Volver-era/ERA-platform./README.md

# ©ERA-platform.2022
Платформа для разработке на ее основе собственных роботов 
- VK:https://vk.com/explorerrobotanimal
- Twitter:https://twitter.com/ERA17434195?s=09
- YouTube:https://youtube.com/channel/UC19MgV3cm7GwOPX2njeCrkA
