Volver-era/ERA-platform./малые версии платформы/ERA v3/README.md

# Что нового:
- 1)Немного переделана можель платформы
- 2)добавлена 2-ая точка крепления ног, из за чего практически изчез люфт конечностей 
- 3)Контроллер быд заменен на STM31f401
- 4)Сервоприводы изменены на MG90S
