Volver-era/ERA-platform./малые версии платформы/ERA v3/инструкция по сборке/README.md

# Что понадобится 
-   Основные компоненты:
-     *STM32F401 (STM32F103, STM32F411 или любая плата Adruino с достаточным количеством портов)
-     *Li-ion аккумуляторы 18650(x2)
-     *Сервоприводы (Mg90s) (х12)
-   Второстепенные компоненты: 
-     *Провода(тонкие – сигнальные, толстые – на питание)
-     *Переключатель питания
-     *Холдер для 18650 
-     *Термоусадочная трубка
-     *Гайки М3 (х4)
-     *Болты М3х10 (х4)
-     *Болты М3х5 (х12)
-     *Стержни (х24)
-     *Саморезы (для крепления сервоприводов) (х52)
-   Инструменты и оборудование:
-     *3D-принтер 
-     *Паяльник и припой 
-     *Супер клей
-     *Нож 
-     *USB-кабель прошивки arduino
-     *Пк/ноутбук для программирования робота, печати и т.д.
-   Программное обеспечение:
-     *Arduino IDE (для программирования)
-     *Fushion 360 (для редактирования 3D модели)
-     *Ultimaker Cura (для печати модели)

# Cборка

Alt-текст
Печатаем все детали из папки “3D Модель” в количестве указанном в названии 

Alt-текст
Очищаем от поддержек и лишнего пластика  

Alt-текст
Для сборки бедра понадобится:
*напечатанная бедренная часть
*сервопривод (х2)
*стержень(х4)
*саморезы для крепления серв(х8)
*болты (х2)

Alt-текст
Просовываем стержни в место крепления серв 

Alt-текст
вставляем болты в напечатанную модель

Alt-текст
Вставляем сервы со стержнями в напечатанную модель
(причем стараемся просунуть провод управления под вторым сервоприводом)

Alt-текст
Alt-текст
Закручиваем саморезы в стержни с обоих сторон 

Alt-текст
Собираем 4 бедра 
2 левых, и 2 правых

Alt-текст
Для сборки плечевого сустава понадобится:
*напечатанный плечевой сустав
*сервоприводы (х2)
*стержни (х4)
*болты (х2)
*гайки (х2)
*саморезы (х8)

Alt-текст
Также вставляем стержни в место крепления серво 

Alt-текст
так же вставляем болты.
И запрессовываем гайки в предназначенное место 

Alt-текст
вставляем сервы 

Alt-текст
Закручиваем саморезы с двух сторон 

Alt-текст
Для сборки корпуса необходимо смазать клеем все места отмеченные красным цветом 

Alt-текст
И соединить данным образом 
Но так чтобы все стенки были ровно под углом в 90*

Alt-текст
Далее собираем плечи
Для этого нужны плечевые суставы и крепления плечей 

Alt-текст
Alt-текст
Ставим плечевые крепления таким образом чтобы плечи были направлены вперед под углом в 45*

Alt-текст
Далее собираем тело 
Для этого берем склеенное ранее тело, собранные плечи и 4 длинных болта 

Alt-текст
Alt-текст
Alt-текст
Вставляем болты в предназначенные для них места в теле, и прикручиваем плечи  

Alt-текст
Alt-текст
Далее присоединяем бедра, так чтобы сервы были повернуты вниз  

Alt-текст
Alt-текст
И под конец, ставим голени 

Alt-текст
Alt-текст
финальный вид платформы
