Volver-era/ERA-platform./малые версии платформы/ERA v3/модель/README.md

# Настройки для 3D-печати 
-   Пластик:PLA
-   Толщина сопла 0.4
-   Температура сопла 210
-   Температура стола 65
-   Заполнение 15% (сотами)
-   Остальные настройки стандартные 

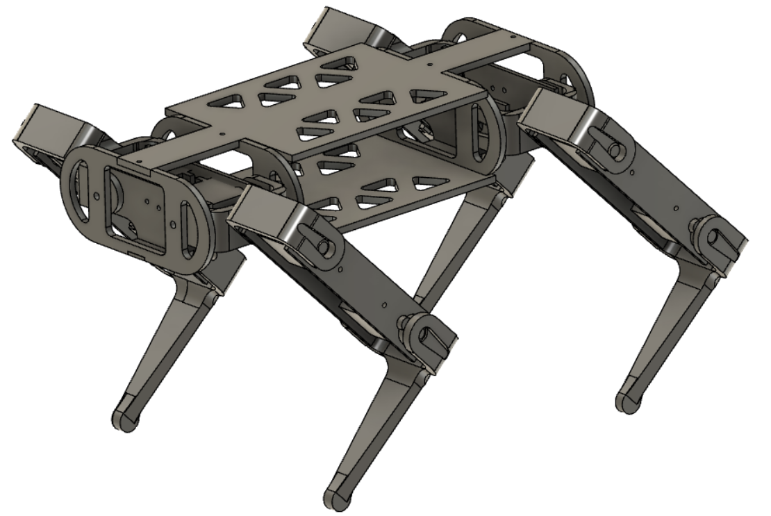
[picture p1: малые версии платформы/ERA v3/модель/Снимок экрана (4).png]
Alt-текст
