Volver-era/ERA-platform./малые версии платформы/ERA v2/README.md

# Что нового:
- 1)Полностью переделана модель платформы 
- 2)Корпусу добавлены стенки, что позволило сделать его крепче, и предотвратить компоненты от удара.
- 3)Контроллер был заменен на Arduino Mega
- 4)Сервоприводы изменены на SG92R
