Volver-era/ERA-platform./малые версии платформы/ERA v1/README.md

# Первая модель платформы
# На первой модели установлены 
- 1)Микроконтроллер Arduino mini
- 2)Cервоприводы Sg90 
# Модель 
- Создана простейшая платформа, для тестирования программы для ходьбы
