Volver-era/ERA-platform./большие версии платформы/ERA v1/фото/03AcDUjwing.jpg

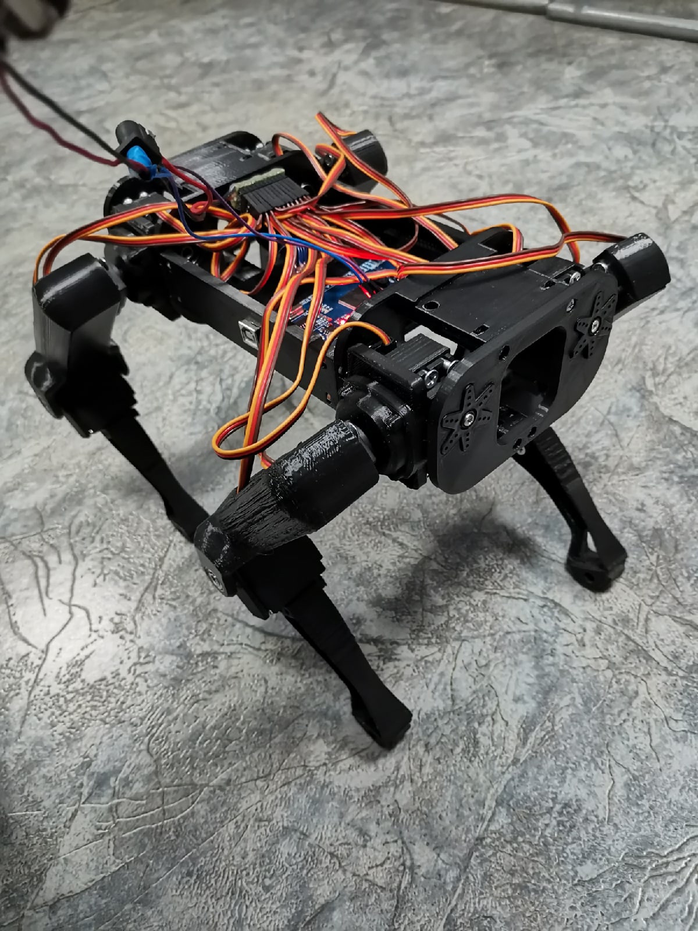
большие версии платформы/ERA v1/фото/03AcDUjwing.jpg
