Volver-era/ERA-platform./большие версии платформы/ERA v1/фото/5-9P0uYwGg0.jpg

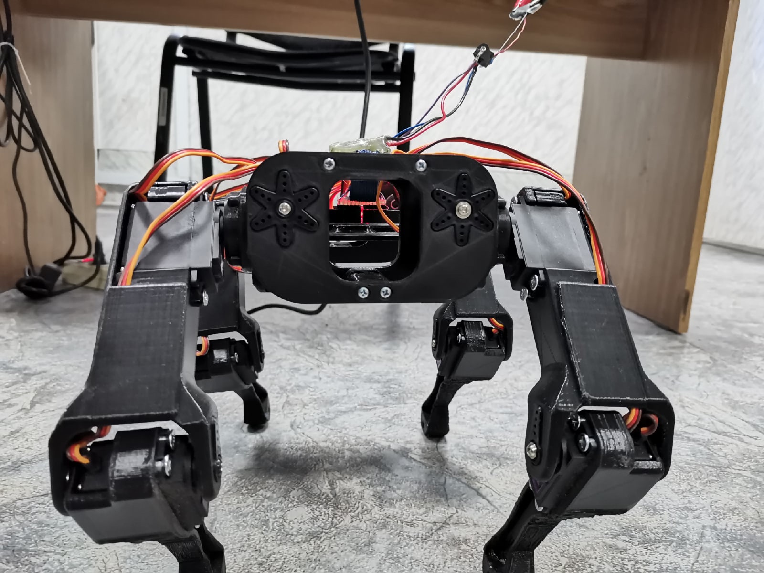
большие версии платформы/ERA v1/фото/5-9P0uYwGg0.jpg
