Volver-era/ERA-platform./большие версии платформы/ERA v1/фото/fQCVnL3XfMo.jpg

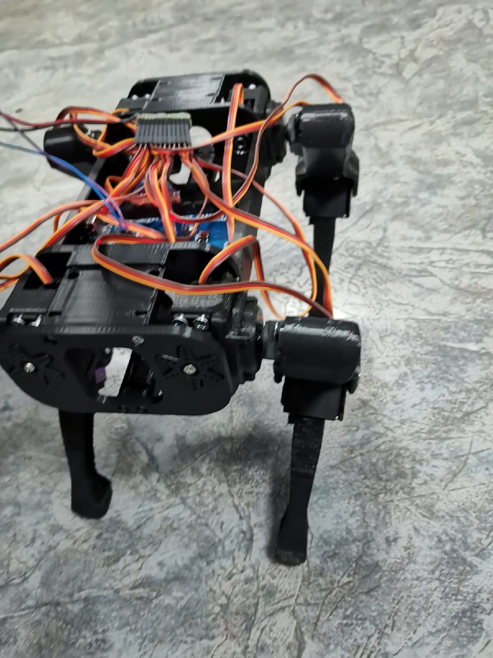
большие версии платформы/ERA v1/фото/fQCVnL3XfMo.jpg
