Volver-era/ERA-platform./большие версии платформы/ERA v1/фото/HJ_dtE6l62w.jpg

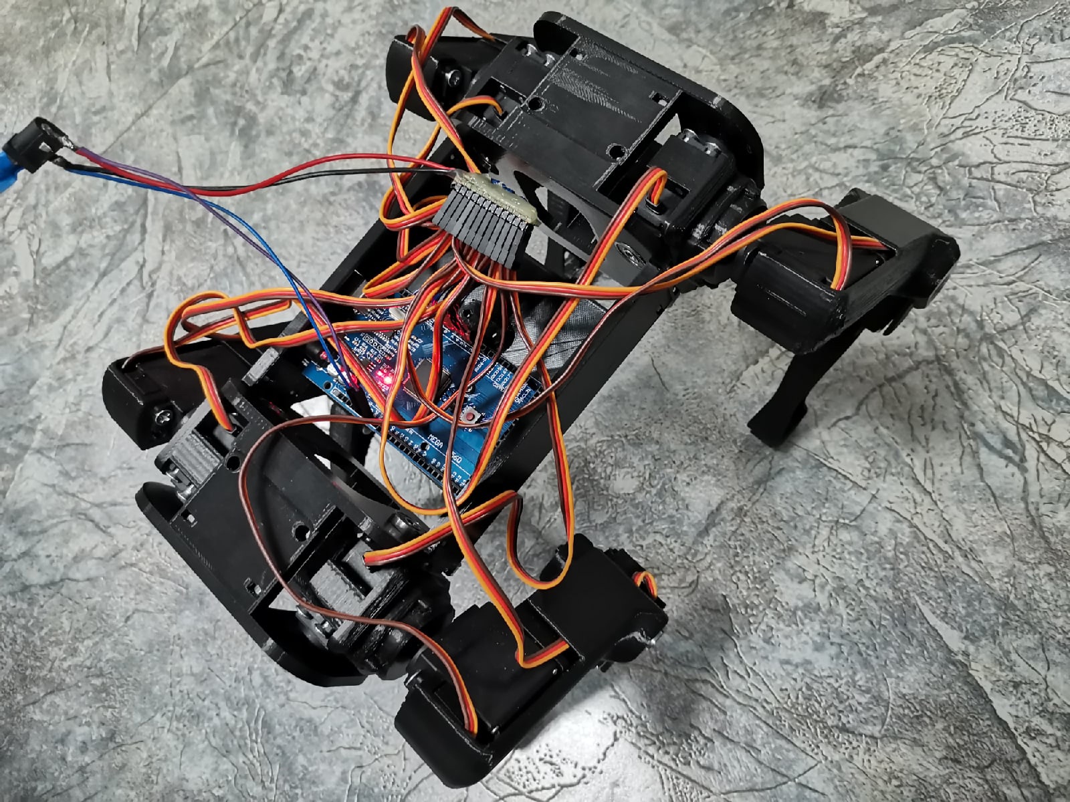
большие версии платформы/ERA v1/фото/HJ_dtE6l62w.jpg
