Volver-era/ERA-platform./большие версии платформы/ERA v1/фото/IlKXpyXIikI.jpg

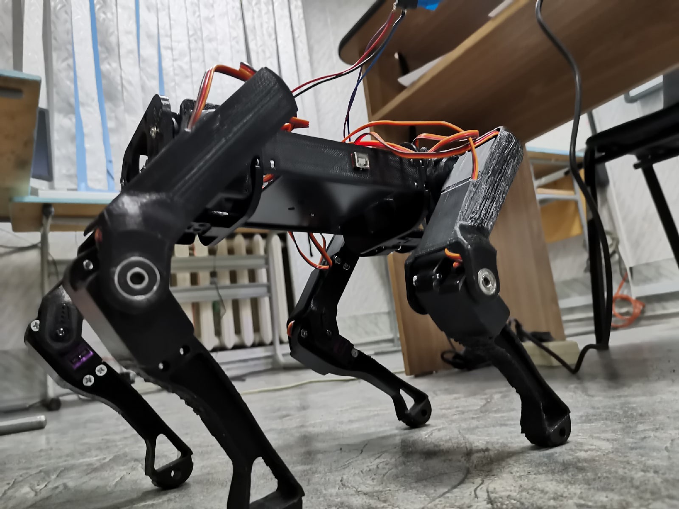
большие версии платформы/ERA v1/фото/IlKXpyXIikI.jpg
