Volver-era/ERA-platform./большие версии платформы/ERA v1/фото/IZdFxkf7L7s.jpg

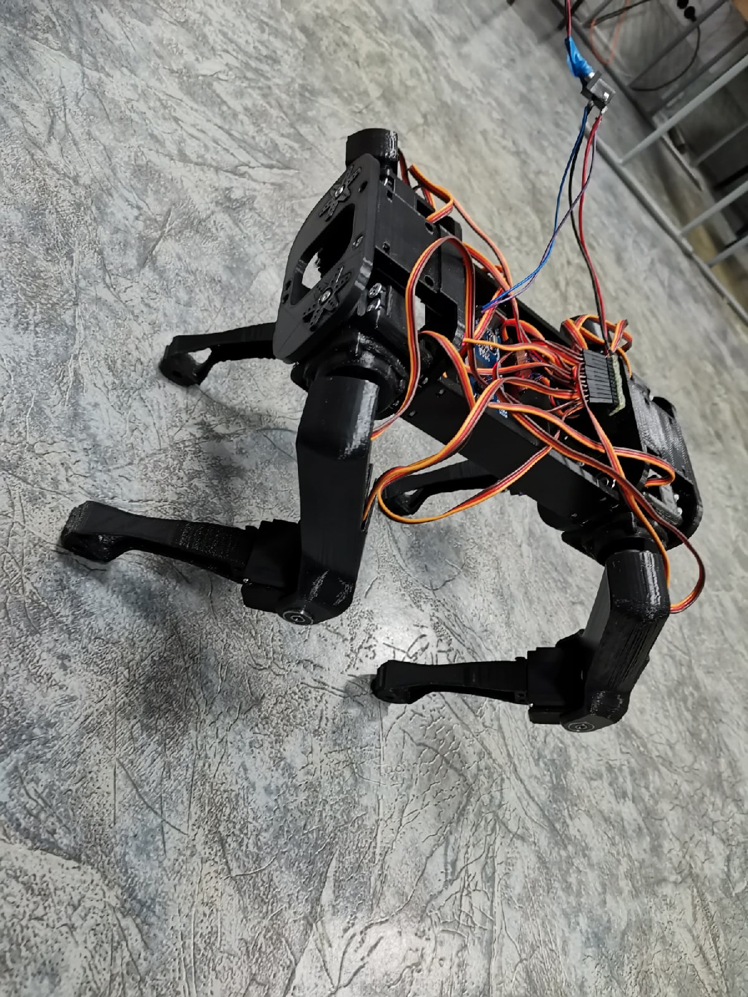
большие версии платформы/ERA v1/фото/IZdFxkf7L7s.jpg
