Volver-era/ERA-platform./большие версии платформы/ERA v1/фото/KXq7CZJiPGc.jpg

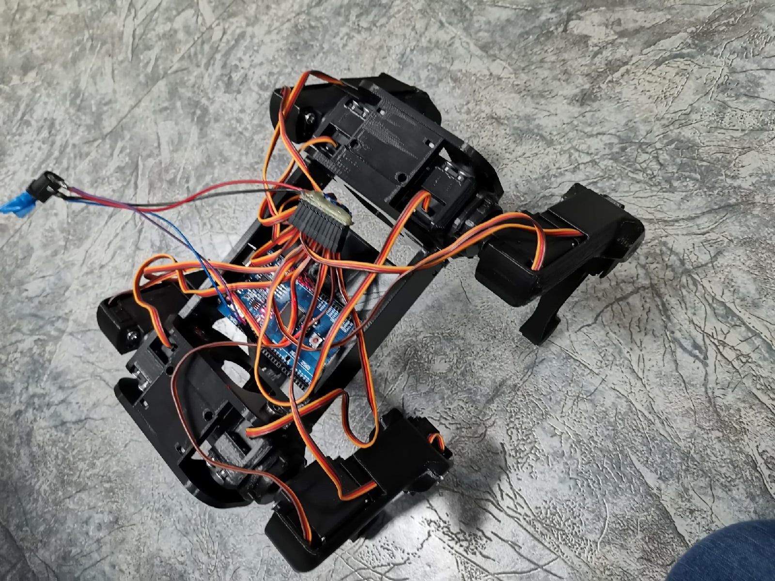
большие версии платформы/ERA v1/фото/KXq7CZJiPGc.jpg
