Volver-era/ERA-platform./большие версии платформы/ERA v1/фото/lwI6eKDuc0o.jpg

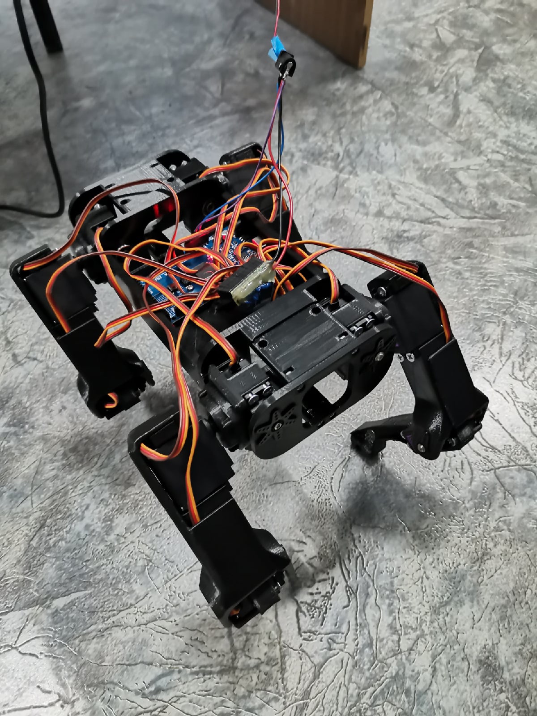
большие версии платформы/ERA v1/фото/lwI6eKDuc0o.jpg
