Volver-era/ERA-platform./большие версии платформы/ERA v1/фото/ov22cSXUDSg.jpg

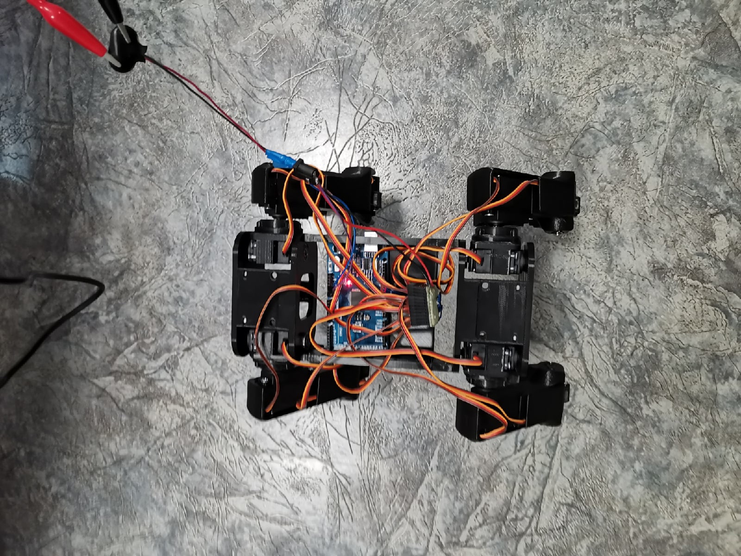
большие версии платформы/ERA v1/фото/ov22cSXUDSg.jpg
