Volver-era/ERA-platform./большие версии платформы/ERA v1/фото/R4x8xW7jYrg.jpg

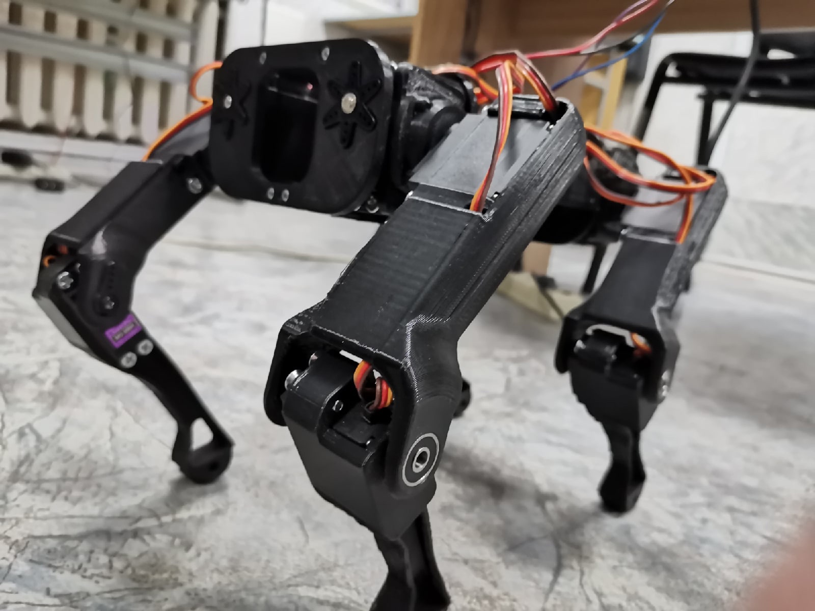
большие версии платформы/ERA v1/фото/R4x8xW7jYrg.jpg
