Volver-era/ERA-platform./большие версии платформы/ERA v1/фото/TSFQKXMkGRk.jpg

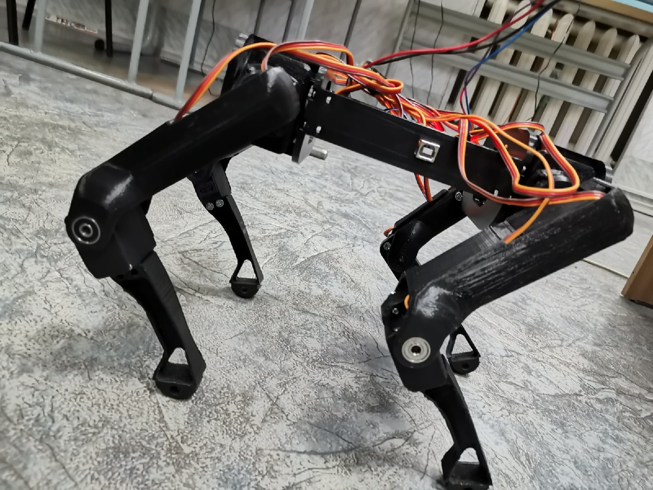
большие версии платформы/ERA v1/фото/TSFQKXMkGRk.jpg
