Volver-era/ERA-platform./большие версии платформы/ERA v1/фото/V23C5B-QcHU.jpg

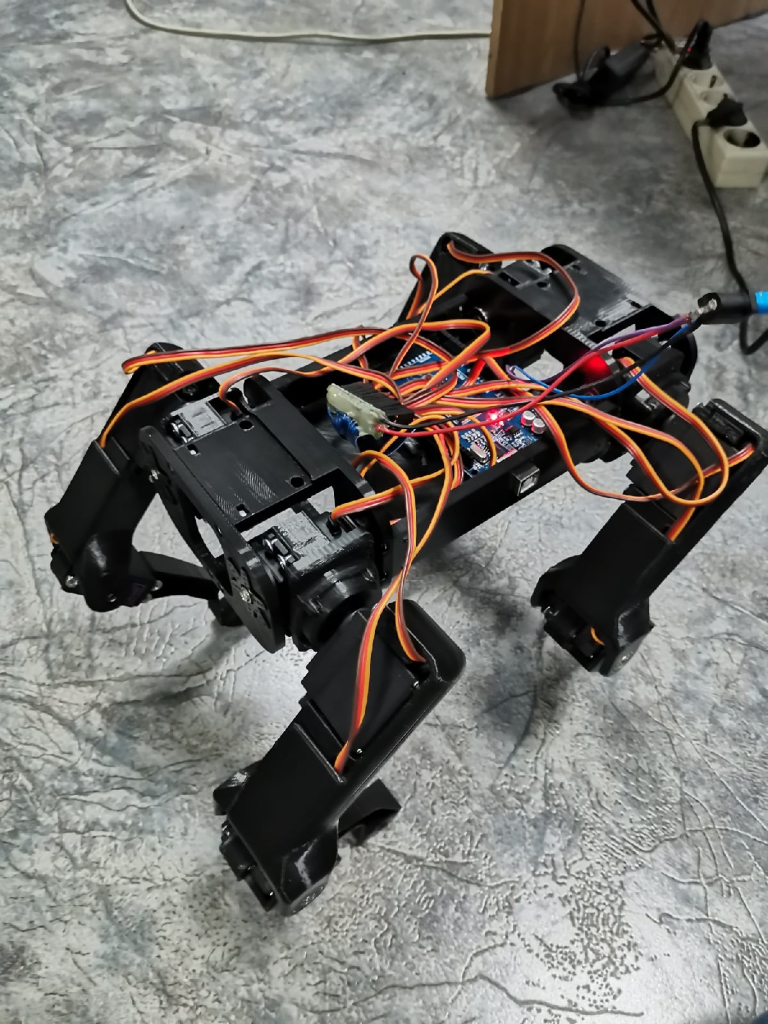
большие версии платформы/ERA v1/фото/V23C5B-QcHU.jpg
