Volver-era/ERA-platform./большие версии платформы/ERA v1/фото/Wf8pfOjVajM.jpg

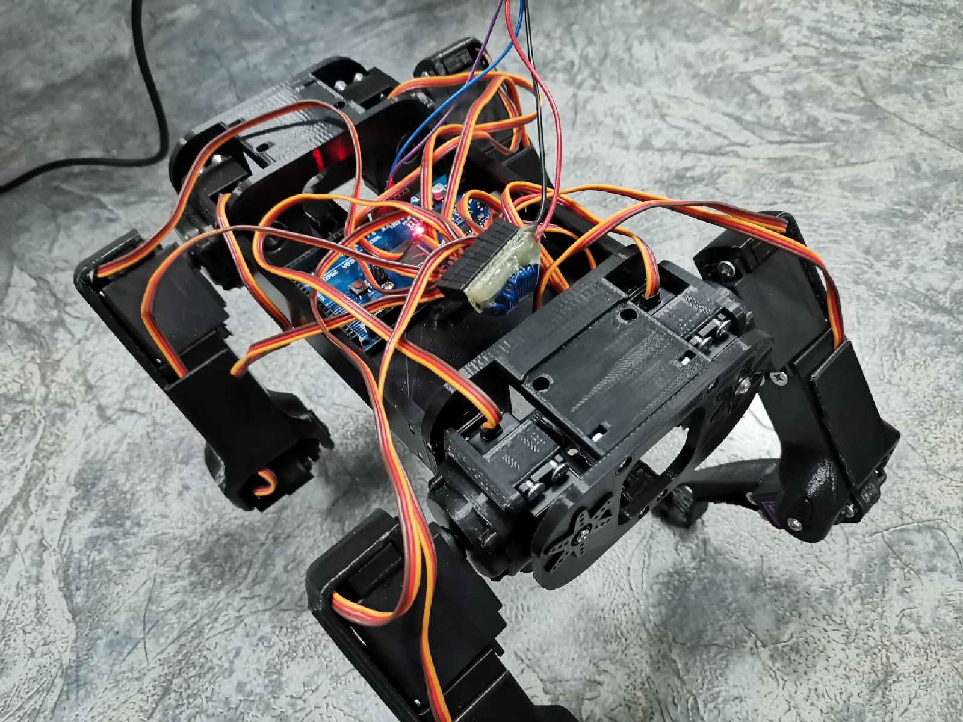
большие версии платформы/ERA v1/фото/Wf8pfOjVajM.jpg
