Volver-era/ERA-platform./большие версии платформы/ERA v1/фото/Ya9wH_taehs.jpg

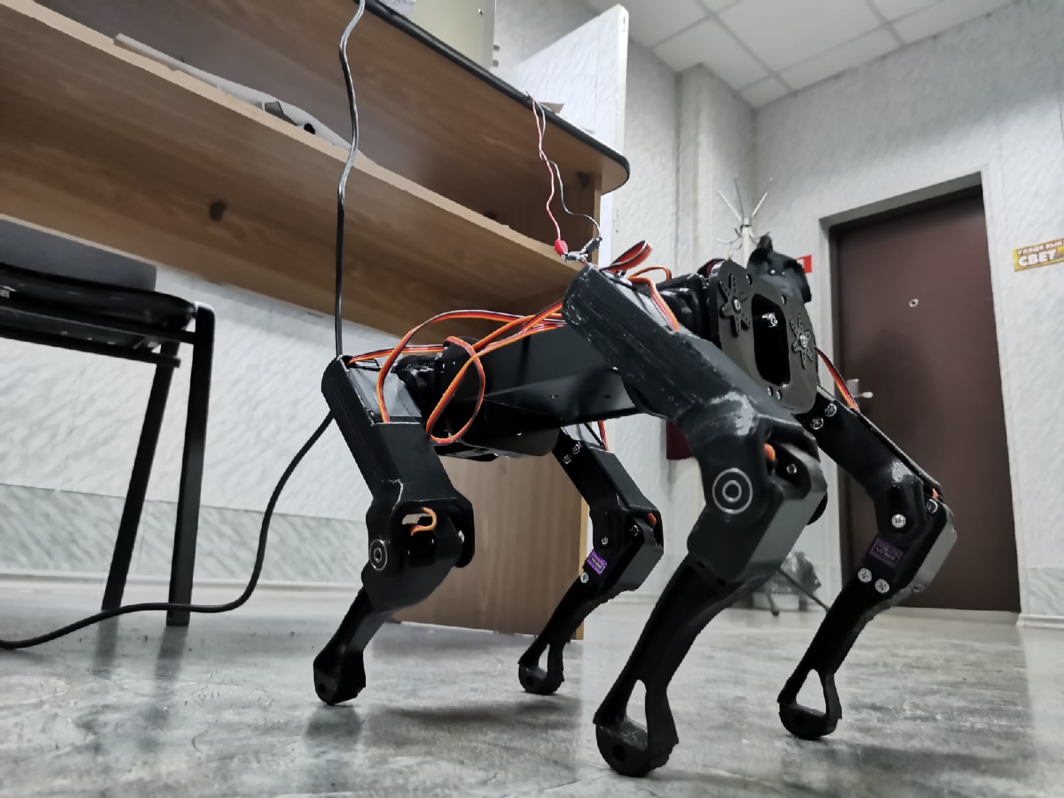
большие версии платформы/ERA v1/фото/Ya9wH_taehs.jpg
