Volver-era/ERA-platform./малые версии платформы/ERA v3/модель/kraja_x2.stl

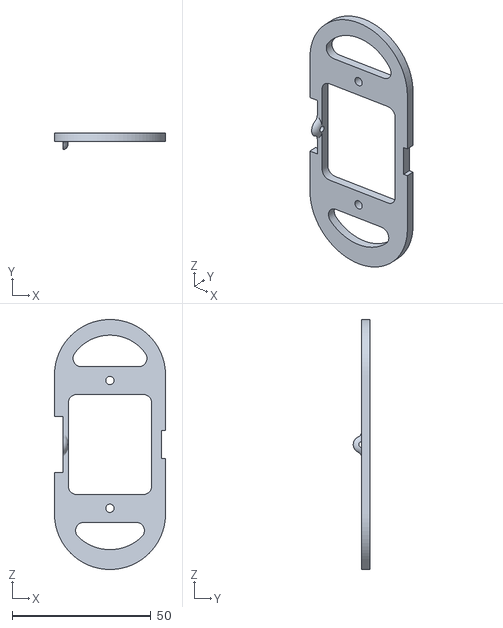
[picture p16: CAD file, 2022-01-12]
малые версии платформы/ERA v3/модель/kraja_x2.stl
40.0 x 5.99 x 90.0
