Volver-era/ERA-platform./малые версии платформы/ERA v3/модель/plecho_lev_pered.stl

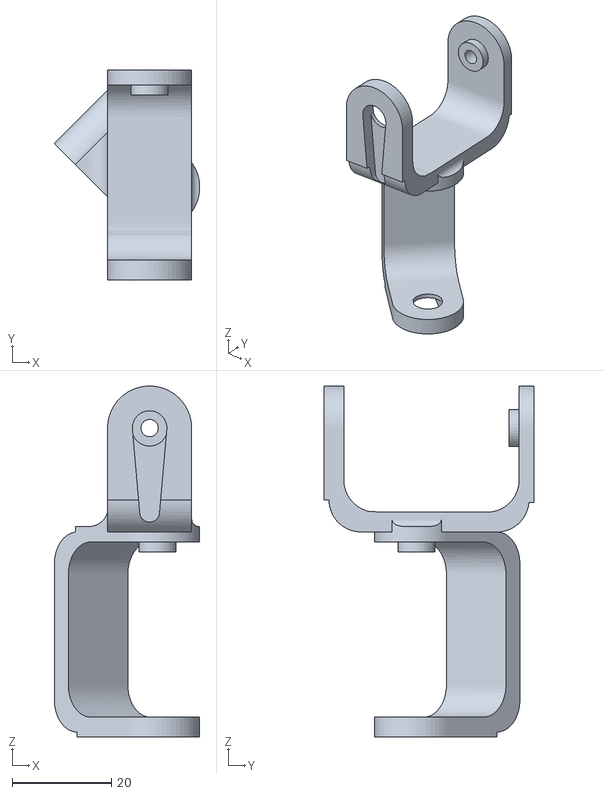
[picture p17: CAD file, 2022-01-12]
малые версии платформы/ERA v3/модель/plecho_lev_pered.stl
29.4 x 42.4 x 70.9
