Volver-era/ERA-platform./малые версии платформы/ERA v3/модель/niz.stl

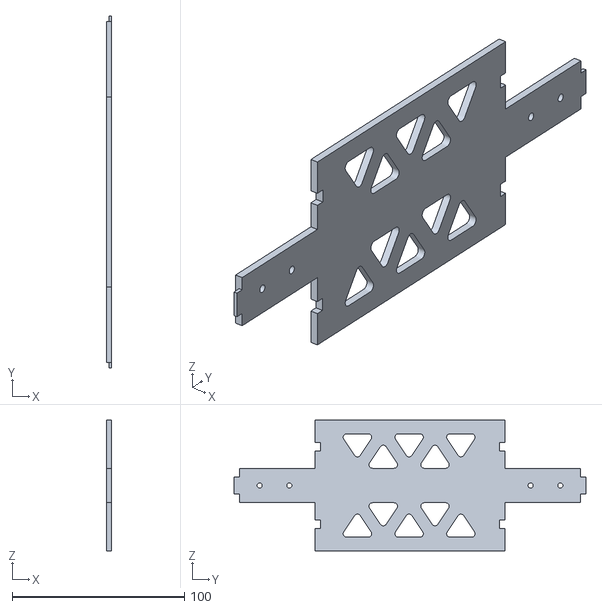
[picture p18: CAD file, 2022-01-12]
малые версии платформы/ERA v3/модель/niz.stl
3.00 x 204.0 x 76.0
