Volver-era/ERA-platform./малые версии платформы/ERA v3/модель/plecho_lev_zad.stl

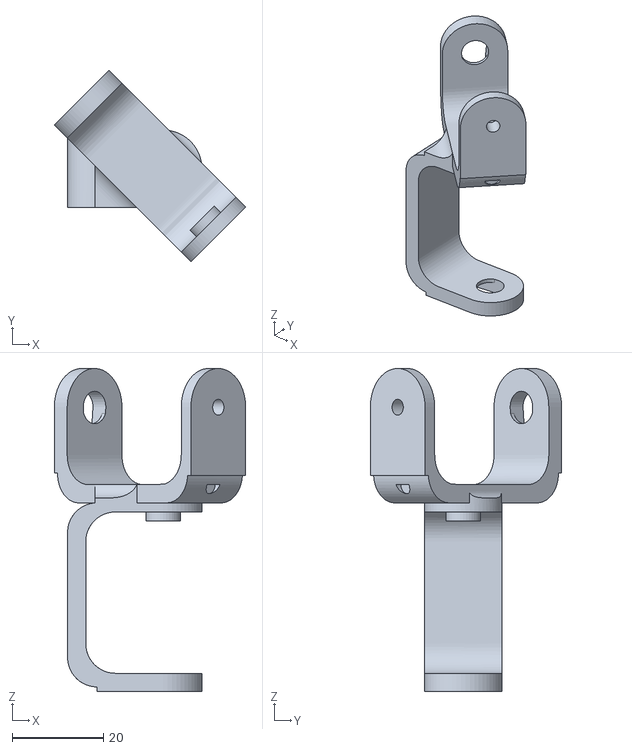
[picture p19: CAD file, 2022-01-12]
малые версии платформы/ERA v3/модель/plecho_lev_zad.stl
42.0 x 42.0 x 70.9
