Volver-era/ERA-platform./малые версии платформы/ERA v3/модель/verkh.stl

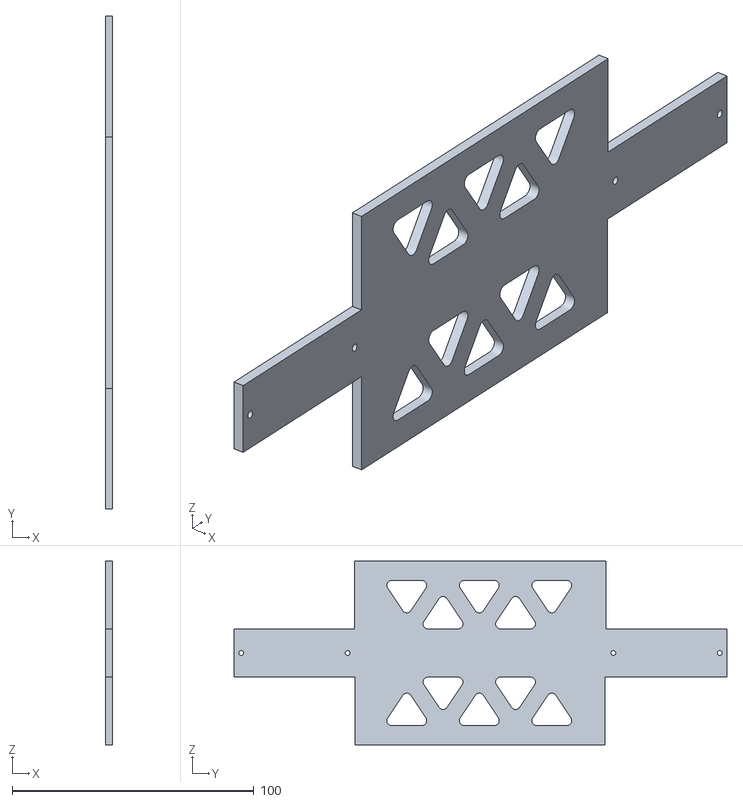
[picture p20: CAD file, 2022-01-12]
малые версии платформы/ERA v3/модель/verkh.stl
3.00 x 204.0 x 76.0
