Volver-era/ERA-platform./малые версии платформы/ERA v3/модель/kreplenie_plech_x2.stl

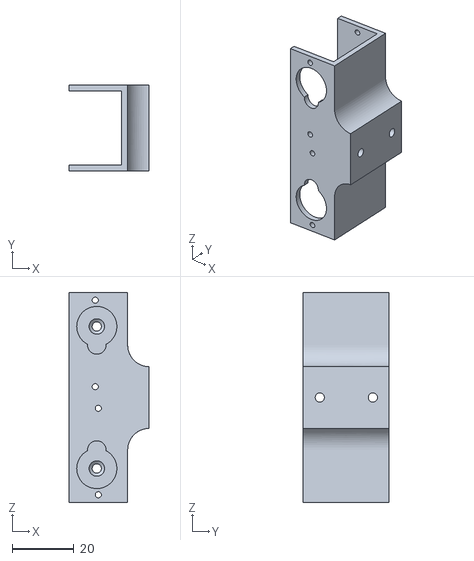
[picture p21: CAD file, 2022-01-12]
малые версии платформы/ERA v3/модель/kreplenie_plech_x2.stl
25.9 x 28.0 x 68.0
