Volver-era/ERA-platform./малые версии платформы/ERA v3/модель/golen_L_х2.stl

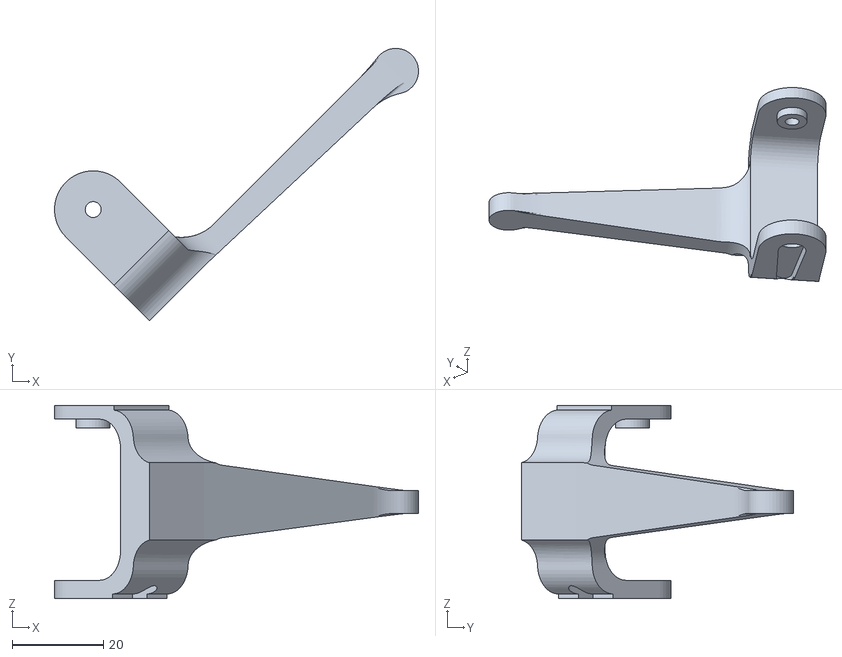
[picture p22: CAD file, 2022-01-12]
малые версии платформы/ERA v3/модель/golen_L_х2.stl
79.9 x 59.8 x 42.4
