Volver-era/ERA-platform./малые версии платформы/ERA v3/модель/bedro_х4.stl

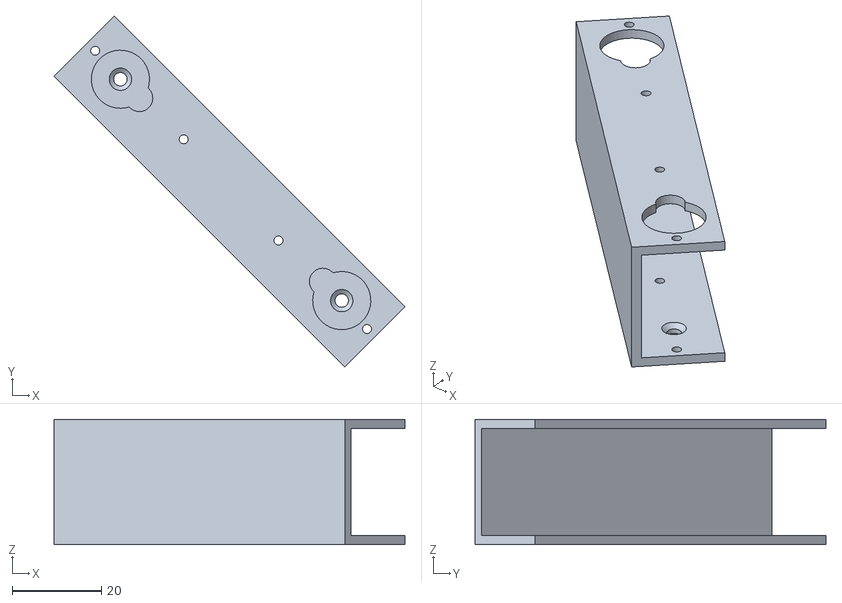
[picture p23: CAD file, 2022-01-12]
малые версии платформы/ERA v3/модель/bedro_х4.stl
78.5 x 78.5 x 28.0
