Volver-era/ERA-platform./малые версии платформы/ERA v2/модель/soedinenie x2.stl

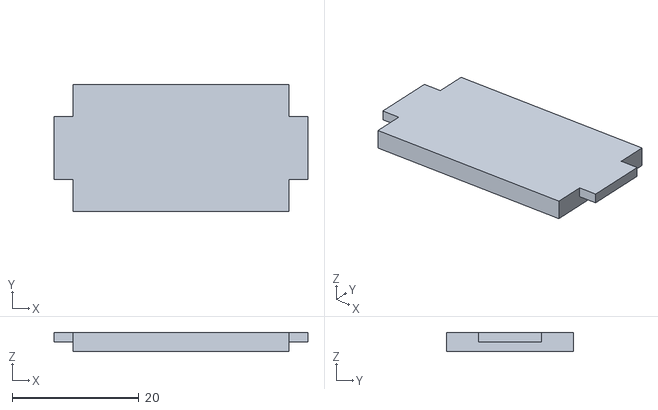
[picture p25: CAD file, 2022-02-15, an earlier design]
малые версии платформы/ERA v2/модель/soedinenie x2.stl
40.0 x 20.0 x 3.00
