Volver-era/ERA-platform./малые версии платформы/ERA v2/модель/seredina x2.stl

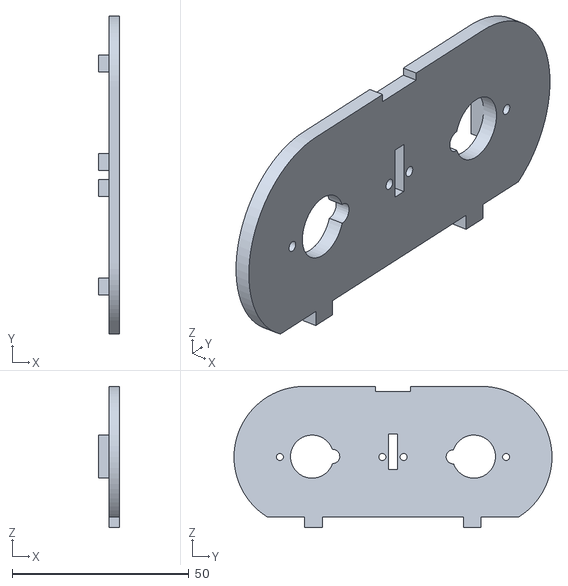
[picture p26: CAD file, 2022-02-15, an earlier design]
малые версии платформы/ERA v2/модель/seredina x2.stl
6.00 x 90.0 x 40.0
