Volver-era/ERA-platform./малые версии платформы/ERA v2/модель/bedro x4.stl

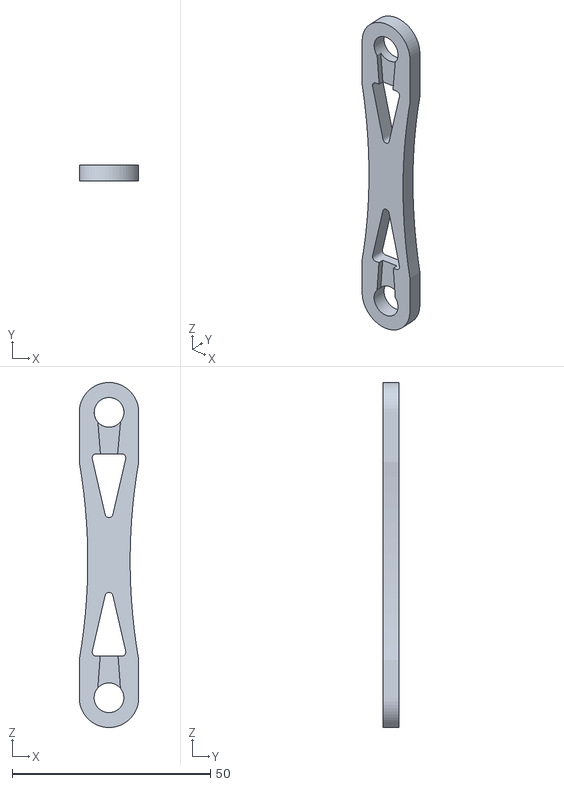
[picture p27: CAD file, 2022-02-15, an earlier design]
малые версии платформы/ERA v2/модель/bedro x4.stl
15.0 x 4.00 x 87.0
