Volver-era/ERA-platform./малые версии платформы/ERA v2/модель/golen x4.stl

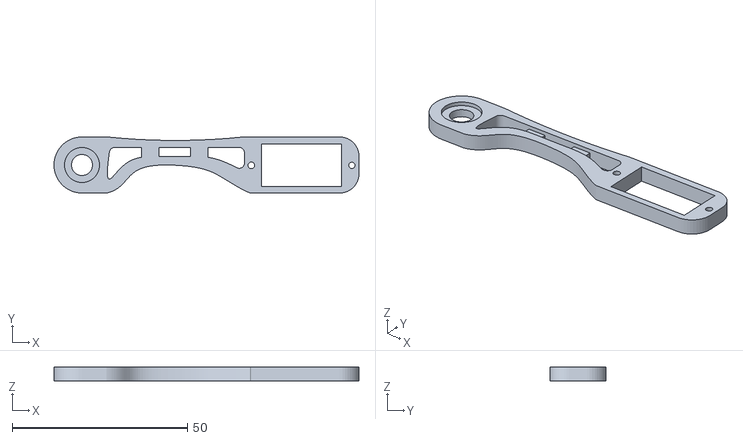
[picture p28: CAD file, 2022-02-15, an earlier design]
малые версии платформы/ERA v2/модель/golen x4.stl
87.0 x 16.0 x 4.00
