Volver-era/ERA-platform./малые версии платформы/ERA v2/модель/plechi x4.stl

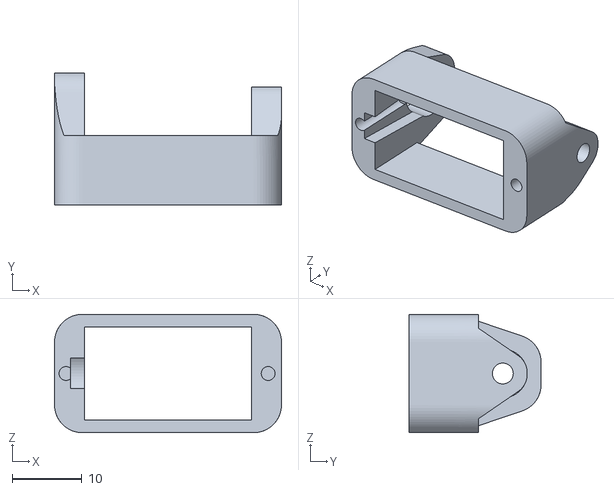
[picture p29: CAD file, 2022-02-15, an earlier design]
малые версии платформы/ERA v2/модель/plechi x4.stl
32.6 x 19.0 x 17.0
