Volver-era/ERA-platform./малые версии платформы/ERA v2/модель/tsentr x1.stl

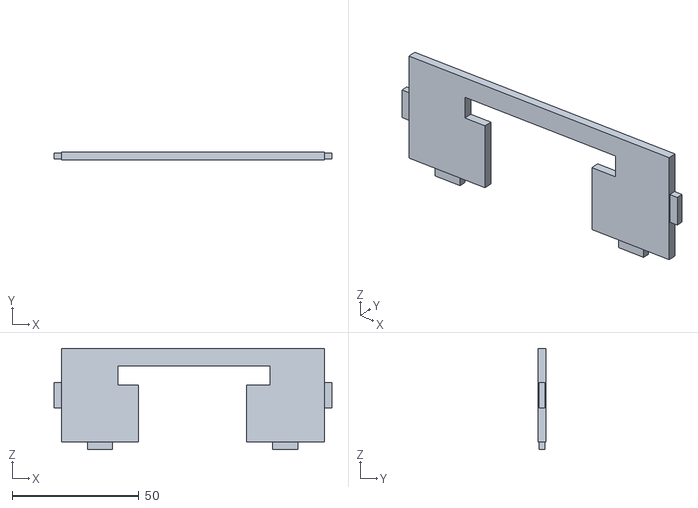
[picture p30: CAD file, 2022-02-15, an earlier design]
малые версии платформы/ERA v2/модель/tsentr x1.stl
109.7 x 3.00 x 40.0
