Volver-era/ERA-platform./(list of files, cad)

Other CAD files:
малые версии платформы/ERA v3/модель/plecho_prav_pered.stl
малые версии платформы/ERA v3/модель/plecho_prav_zad.stl
малые версии платформы/ERA v3/модель/golen_R_х2.stl
малые версии платформы/ERA v2/модель/ERA v2.f3d .f3d
малые версии платформы/ERA v2/модель/pyzo x1.stl
